rafaeldipre/TEDAC_HID/Core/Src/main.c

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
/* Includes ------------------------------------------------------------------*/
#include "main.h"
#include "usb_device.h"

/* USER CODE BEGIN Includes */
#include "usbd_custom_hid_if.h"
/* USER CODE END Includes */

ADC_HandleTypeDef hadc1;
DMA_HandleTypeDef hdma_adc1;

TIM_HandleTypeDef htim15;

/* USER CODE BEGIN PV */
/*
 * CRITICAL: adc_buf MUST be in D2 SRAM (0x30000000) because DMA1 lives in the
 * D2 bus-matrix domain and CANNOT access D1 AXI SRAM (0x24000000 / RAM_D1).
 * Without this attribute the linker places it in .bss → RAM_D1 → DMA writes go nowhere.
 */
volatile uint16_t adc_buf[6] __attribute__((section(".RAM_D2")));
/* USER CODE END PV */

void SystemClock_Config(void);
static void MPU_Config(void);
static void MX_GPIO_Init(void);
static void MX_DMA_Init(void);
static void MX_ADC1_Init(void);
static void MX_TIM15_Init(void);
/**
  * @brief  The application entry point.
  * @retval int
  */
int main(void)
{

  /* MPU Configuration--------------------------------------------------------*/
  MPU_Config();

  /* MCU Configuration--------------------------------------------------------*/

  /* Reset of all peripherals, Initializes the Flash interface and the Systick. */
  HAL_Init();

  /* Configure the system clock */
  SystemClock_Config();

  /* Initialize all configured peripherals */
  MX_GPIO_Init();
  MX_DMA_Init();
  MX_ADC1_Init();
  MX_TIM15_Init();
  MX_USB_DEVICE_Init();
  /* USER CODE BEGIN 2 */
  if (HAL_ADCEx_Calibration_Start(&hadc1, ADC_CALIB_OFFSET, ADC_SINGLE_ENDED) != HAL_OK)
  {
    Error_Handler();
  }

  if (HAL_ADC_Start_DMA(&hadc1, (uint32_t*)adc_buf, 6) != HAL_OK)
  {
    Error_Handler();
  }

  if (HAL_TIM_Base_Start_IT(&htim15) != HAL_OK)
  {
    Error_Handler();
  }
  /* USER CODE END 2 */

  /* Infinite loop */
  /* USER CODE BEGIN WHILE */
  while (1)
  {
    /* USER CODE END WHILE */

    /* USER CODE BEGIN 3 */
  }
  /* USER CODE END 3 */
}

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
/* USER CODE BEGIN 4 */
void HAL_TIM_PeriodElapsedCallback(TIM_HandleTypeDef *htim)
{
  if (htim->Instance == TIM15)
  {
    JOYSTICK_SendReport();
  }
}

/*
 * DCache invalidation callbacks — belt-and-suspenders defence.
 * RAM_D2 is already marked non-cacheable by MPU_Config (Region 1),
 * so these are normally no-ops. If the MPU were ever misconfigured,
 * these callbacks ensure the CPU sees fresh DMA data.
 */
void HAL_ADC_ConvCpltCallback(ADC_HandleTypeDef *hadc)
{
  if (hadc->Instance == ADC1)
  {
    SCB_InvalidateDCache_by_Addr((uint32_t *)adc_buf, sizeof(adc_buf));
  }
}

void HAL_ADC_ConvHalfCpltCallback(ADC_HandleTypeDef *hadc)
{
  if (hadc->Instance == ADC1)
  {
    SCB_InvalidateDCache_by_Addr((uint32_t *)adc_buf, sizeof(adc_buf));
  }
}
/* USER CODE END 4 */

 /* MPU Configuration */

void MPU_Config(void)
{
  MPU_Region_InitTypeDef MPU_InitStruct = {0};

  /* Disables the MPU */
  HAL_MPU_Disable();

  /* Region 0: default — whole 4GB no-access background region */
  MPU_InitStruct.Enable = MPU_REGION_ENABLE;
  MPU_InitStruct.Number = MPU_REGION_NUMBER0;
  MPU_InitStruct.BaseAddress = 0x0;
  MPU_InitStruct.Size = MPU_REGION_SIZE_4GB;
  MPU_InitStruct.SubRegionDisable = 0x87;
  MPU_InitStruct.TypeExtField = MPU_TEX_LEVEL0;
  MPU_InitStruct.AccessPermission = MPU_REGION_NO_ACCESS;
  MPU_InitStruct.DisableExec = MPU_INSTRUCTION_ACCESS_DISABLE;
  MPU_InitStruct.IsShareable = MPU_ACCESS_SHAREABLE;
  MPU_InitStruct.IsCacheable = MPU_ACCESS_NOT_CACHEABLE;
  MPU_InitStruct.IsBufferable = MPU_ACCESS_NOT_BUFFERABLE;
  HAL_MPU_ConfigRegion(&MPU_InitStruct);

  /*
   * Region 1: RAM_D2 (0x30000000, 32K) — non-cacheable, non-bufferable.
   * DMA1 writes adc_buf[] here. The D-Cache must NOT cache this region or
   * the CPU will read stale values. TEX=1, C=0, B=0 = Normal, non-cacheable.
   */
  MPU_InitStruct.Enable = MPU_REGION_ENABLE;
  MPU_InitStruct.Number = MPU_REGION_NUMBER1;
  MPU_InitStruct.BaseAddress = 0x30000000;
  MPU_InitStruct.Size = MPU_REGION_SIZE_32KB;
  MPU_InitStruct.SubRegionDisable = 0x00;
  MPU_InitStruct.TypeExtField = MPU_TEX_LEVEL1;
  MPU_InitStruct.AccessPermission = MPU_REGION_FULL_ACCESS;
  MPU_InitStruct.DisableExec = MPU_INSTRUCTION_ACCESS_DISABLE;
  MPU_InitStruct.IsShareable = MPU_ACCESS_NOT_SHAREABLE;
  MPU_InitStruct.IsCacheable = MPU_ACCESS_NOT_CACHEABLE;
  MPU_InitStruct.IsBufferable = MPU_ACCESS_NOT_BUFFERABLE;
  HAL_MPU_ConfigRegion(&MPU_InitStruct);

  /* Enables the MPU */
  HAL_MPU_Enable(MPU_PRIVILEGED_DEFAULT);
}

/**
  * @brief  This function is executed in case of error occurrence.
  * @retval None
  */
void Error_Handler(void)
{
  /* USER CODE BEGIN Error_Handler_Debug */
  /* User can add his own implementation to report the HAL error return state */
  __disable_irq();
  while (1)
  {
  }
  /* USER CODE END Error_Handler_Debug */
}
#ifdef USE_FULL_ASSERT
/**
  * @brief  Reports the name of the source file and the source line number
  *         where the assert_param error has occurred.
  * @param  file: pointer to the source file name
  * @param  line: assert_param error line source number
  * @retval None
  */
void assert_failed(uint8_t *file, uint32_t line)
{
  /* USER CODE BEGIN 6 */
  /* User can add his own implementation to report the file name and line number,
     ex: printf("Wrong parameters value: file %s on line %d\r\n", file, line) */
  /* USER CODE END 6 */
}
#endif /* USE_FULL_ASSERT */
