rafaeldipre/TEDAC_HID/(commit log)

2026-02-17 Initial commit: TEDAC AH-64D USB HID Joystick firmware
    STM32H723ZGT6-based custom USB HID joystick for DCS World AH-64D Apache TEDAC.
    - 69 digital buttons (TDU, LHG, RHG groups)
    - 6 analog axes (16-bit signed, X/Y/Z/Rx/Ry/Rz)
    - USB Custom HID descriptor with no Report ID for max compatibility
    - 1ms USB poll interval, TIM15 interrupt-driven report sending
    - ADC1 with circular DMA for analog inputs
    - Pin mapping documentation (PDF in English and Spanish)
2026-02-17 Fix ADC not scanning 6 channels + add README
    - ADC was configured with ScanConvMode=DISABLE and NbrOfConversion=1,
    causing only 1 channel to be converted. Re-initialize ADC in USER CODE
    block with ScanConvMode=ENABLE, NbrOfConversion=6, correct channel
    assignments (IN3/PA6, IN7/PA7, IN14/PA2, IN15/PA3, IN10/PC0, IN11/PC1)
    - Add README crediting MilKris666 TEDAC v2.0 mechanical design
    [main.c]
2026-02-17 Fix ADC1 6-channel scan + sync CubeMX ioc mapping
    [TEDAC_HID.ioc, main.c]
2026-02-17 Fix ADC scan + 10-bit scaling for HID axes
    [TEDAC_HID.ioc, main.c]
2026-02-18 fix: ADC DMA multicanal + USB HID report funcional en STM32H723ZGT6
    Problemas resueltos:
    - ADC: CubeMX generaba ScanConvMode=DISABLE y NbrOfConversion=1.
    Corregido a SCAN_ENABLE, NbrOfConversion=6, EOC_SEQ_CONV,
    OVR_DATA_OVERWRITTEN y secuencia correcta CH3/7/14/15/10/11.
    - PCSEL_RES0: el registro de preseleccion de canales del H723 debe
    escribirse con ADEN=0 (antes de HAL_ADC_Init). Si se escribe despues
    el hardware ignora el write silenciosamente. Movido a ADC1_Init 1.
    - DMA/Cache: adc_buf movido a RAM_D2 (0x30000000) con seccion
    .RAM_D2 (NOLOAD) en linker script. MPU Region1 non-cacheable
    para toda RAM_D2. Callbacks SCB_InvalidateDCache como defensa extra.
    - USB HID: report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
2026-02-19 feat: expand digital inputs from 69 to 72 buttons
    Add BTN_70 (TDU Off, PG15), BTN_71 (Spare1, PF7), BTN_72 (Spare2, PF8)
    to support the Day/NT/Off 3-position TDU switch in DCS World.
    72 buttons fit exactly in 9 bytes (no padding bits needed), so the
    HID descriptor shrinks from 55 to 49 bytes and the padding item
    is removed. Report payload stays at 21 bytes.
2026-02-19 docs: add PINOUT.md with full 72-button pin assignment table
    Add dedicated PINOUT.md with complete pin mapping for all 72 buttons
    and 6 ADC axes, organized by group (TDU/LHG/RHG/Spare) with GPIO
    port summary and HID report format. Update README to reflect 72
    buttons and link to PINOUT.md.
2026-02-19 docs: add PINOUT_EN.md — English pin assignment table
    English version of PINOUT.md with full 72-button and 6-axis mapping.
2026-02-19 docs: add IMPLEMENTATION_NOTES_EN.md + update Spanish notes to 72 buttons
    Add English translation of implementation notes. Also fix outdated
    references in the Spanish version: button count 69→72, descriptor
    size 55→49 bytes, remove 3-bit padding item from HID descriptor
    snippet, update GPIO pin distribution table.
2026-02-19 fix: restore static report buffer and CUSTOM_HID_BUSY check
    Linter had reverted both critical USB HID fixes:
    - report[] must be static so USB DMA does not read stack garbage
    after JOYSTICK_SendReport returns
    - CUSTOM_HID_BUSY guard prevents endpoint saturation that corrupts
    middleware state and freezes all axes and buttons
2026-02-19 fix: skip spare BTN 71/72 reads to prevent floating-pin false triggers
    PF7 and PF8 have nothing wired yet. The weak internal pull-up (~40kΩ)
    is insufficient to hold the pins HIGH on this board, causing them to
    read as pressed. Skip indices 70-71 in the button loop until a switch
    is physically connected to those pins.
2026-02-19 revert: back to 69-button working state + keep USB HID fixes
    Revert firmware to commit 1109455 (69 buttons, descriptor 55 bytes,
    3-bit padding). Keep static report buffer and CUSTOM_HID_BUSY guard
    which are required for stable USB operation regardless of button count.
    [main.c, main.h]
2026-02-19 feat: add BTN 70 (PG15 TDU Off) + spare GPIO BTN 71/72 (PF7/PF8)
    - HID report: 69→70 buttons (70 bits + 2 pad = 9 bytes, report stays 21 bytes)
    - Descriptor size unchanged at 55 bytes, only UsageMax/Count updated
    - BTN 71/72 GPIO init included (pull-up) but excluded from HID report
    until physically wired, avoiding floating-pin false triggers
    [main.c, main.h]
2026-02-19 fix: correct button count to 72 in HID descriptor and arrays
    Previous commit used 70 instead of 72. 72 buttons = 72 bits = 9 bytes
    exactly, no padding needed. Update descriptor (UsageMax 0x48, Count
    0x48, remove padding item), REPORT_DESC_SIZE 55→49, arrays [72],
    loop bound 72, add PF7/PF8 (BTN 71/72) to port/pin arrays.
2026-02-21 feat: add LHG 2-stage trigger (BTN 73/74) — 74 buttons total
    - Add BTN 73 (LHG TRIG POS1, PD13) and BTN 74 (LHG TRIG POS2, PD14)
    - LHG corrected from 26 to 28 buttons; project total 72 → 74 buttons
    - HID descriptor: Usage Maximum 0x48 → 0x4A, Report Count 0x48 → 0x4A
    + 6-bit const padding to align 74 bits to 10 bytes
    - Report buffer: 21 → 22 bytes; button loop 72 → 74 iterations
    - CUSTOM_HID_EPIN_SIZE: 0x15 → 0x16 (22 bytes)
    - USBD_CUSTOM_HID_REPORT_DESC_SIZE: 49 → 55 bytes
    - GPIO init (GPIOD): add PD13 + PD14 with PULLUP
    - Replace old PDFs with new TEDAC_Button_Assignment.pdf (color-coded)
    - Add tools/generate_pdf.py (reportlab PDF generator)
    - Update PINOUT.md + PINOUT_EN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
    [generate_pdf.py, main.c, main.h]
2026-02-23 feat: add RHG SW8/SW9 (BTN 75/76) — 76 buttons total
    - Add BTN 75 (RHG SW8, PG0) and BTN 76 (RHG SW9, PG1)
    - RHG expands from 25 to 27 buttons; project total 74 → 76 buttons
    - HID descriptor: Usage Maximum 0x4A → 0x4C, Report Count 0x4A → 0x4C
    padding reduced from 6 bits to 4 bits (still 10-byte button field)
    - GPIO init (GPIOG): add PG0 + PG1 with PULLUP
    - btn_port/btn_pin arrays: 74 → 76 entries
    - Button loop updated: 74 → 76 iterations
    - Report size and descriptor size unchanged (22 bytes / 55 bytes)
    - Regenerate TEDAC_Button_Assignment.pdf with updated RHG table
    - Update PINOUT.md + PINOUT_EN.md for 76-button layout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
2026-02-27 Reasignar BTN48/BTN49 de PC8/PC9 a PF11/PF12
    PC8 y PC9 no responden correctamente en pruebas de hardware
    (pin flotante sigue en LOW a pesar de PULLUP activo).
    Se mueven RHG SW1 y RHG SW2 a pines libres de GPIOF:
    BTN 48 (RHG SW1): PC8 → PF11
    BTN 49 (RHG SW2): PC9 → PF12
    Archivos actualizados:
    - Core/Inc/main.h: nuevos defines GPIOF/GPIO_PIN_11,12
    - Core/Src/main.c: GPIOC init sin PC8/PC9; GPIOF init con PF11/PF12
    - USB_DEVICE/App/usbd_custom_hid_if.c: btn_port y btn_pin corregidos
    - PINOUT.md, PINOUT_EN.md: tablas y resumen de puertos actualizados
    - tools/generate_pdf.py + PDF regenerado
    - TEDAC_HID.ioc: USBD_CUSTOM_HID_REPORT_DESC_SIZE corregido a 0x37 (55)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
    [TEDAC_HID.ioc, generate_pdf.py, main.c, main.h]
2026-02-27 Añadir BTN 77-78 en PB14/PB15 para diagnóstico (78 botones)
    PF11/PF12 leen LOW sin conexión — problema de hardware en esas
    trazas del PCB. Se añaden dos botones de prueba en GPIOB (ya
    demostrado funcional con BTN 30-43) para verificar el firmware:
    BTN 77 (TEST1): PB14 — GPIOB, GPIO_PIN_14
    BTN 78 (TEST2): PB15 — GPIOB, GPIO_PIN_15
    HID: 78 bits + 2-bit padding = 80 bits = 10 bytes (sin cambio
    en report size ni EPIN_SIZE — sigue en 22 bytes).
    Descriptor actualizado: Usage Max/Count 0x4C→0x4E, padding 4→2 bits.
    PINOUT.md, PINOUT_EN.md, PDF y generate_pdf.py actualizados.
    [generate_pdf.py, main.c, main.h]
2026-02-27 fix: reasignar BTN48/49 a PB14/PB15 (GPIOB) — volver a 76 botones definitivos
    PF11 y PF12 también leían LOW con pull-up sin nada conectado (defecto
    de hardware en la PCB, igual que PC8/PC9). Se confirma que GPIOB funciona
    correctamente con los botones de diagnóstico BTN77/78 (PB14/PB15).
    Cambios:
    - BTN48 RHG SW1: PF11 → PB14 (GPIOB)
    - BTN49 RHG SW2: PF12 → PB15 (GPIOB)
    - Eliminar BTN77/78 TEST (ya no necesarios): volver a 76 botones
    - Descriptor HID: Usage Max / Count 0x4E → 0x4C, padding 2 → 4 bits
    - btn_port[78] → btn_port[76], btn_pin[78] → btn_pin[76]
    - main.c: GPIOB inicializa PB14/PB15 como BTN48/49; GPIOF sin PF11/PF12
    - PINOUT.md, PINOUT_EN.md, generate_pdf.py y PDF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
    [generate_pdf.py, main.c, main.h]
2026-02-27 feat: agregar BTN77/78 virtuales — 78 botones HID (76 físicos + 2 virtuales)
    BTN77 Virtual A: ON cuando PF3 (RHG HAT1 LEFT) y PF4 (RHG HAT1 RIGHT)
    están ambos sin presionar. virtual_A = !(PF3 || PF4)
    BTN78 Virtual B: ON cuando PD2 (LHG SW3) y PD4 (LHG SW5)
    están ambos sin presionar. virtual_B = !(PD2 || PD4)
    Cambios en firmware:
    - Descriptor HID: Usage Max / Count 0x4C → 0x4E (76 → 78 botones)
    - Padding: 4 bits → 2 bits (78 + 2 = 80 bits = 10 bytes, sin cambio de tamaño)
    - JOYSTICK_SendReport(): lógica virtual añadida tras el loop de 76 botones
    físicos; bit 76 (byte 21 bit 4) = BTN77, bit 77 (byte 21 bit 5) = BTN78
    - btn_port[]/btn_pin[] sin cambios (solo 76 entradas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
